praeclarum/Flybot/Hardware/Case_Flybot.stl

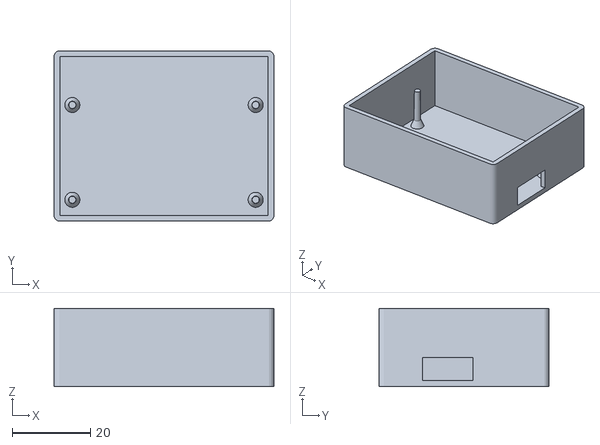
[picture p1: CAD file, 2025-08-27]
Hardware/Case_Flybot.stl
56.4 x 43.7 x 20.0
