praeclarum/Flybot/Hardware/Schematic_Flybot_2025-08-08.pdf

# USBESP⁻WROOM⁻³² WIFI

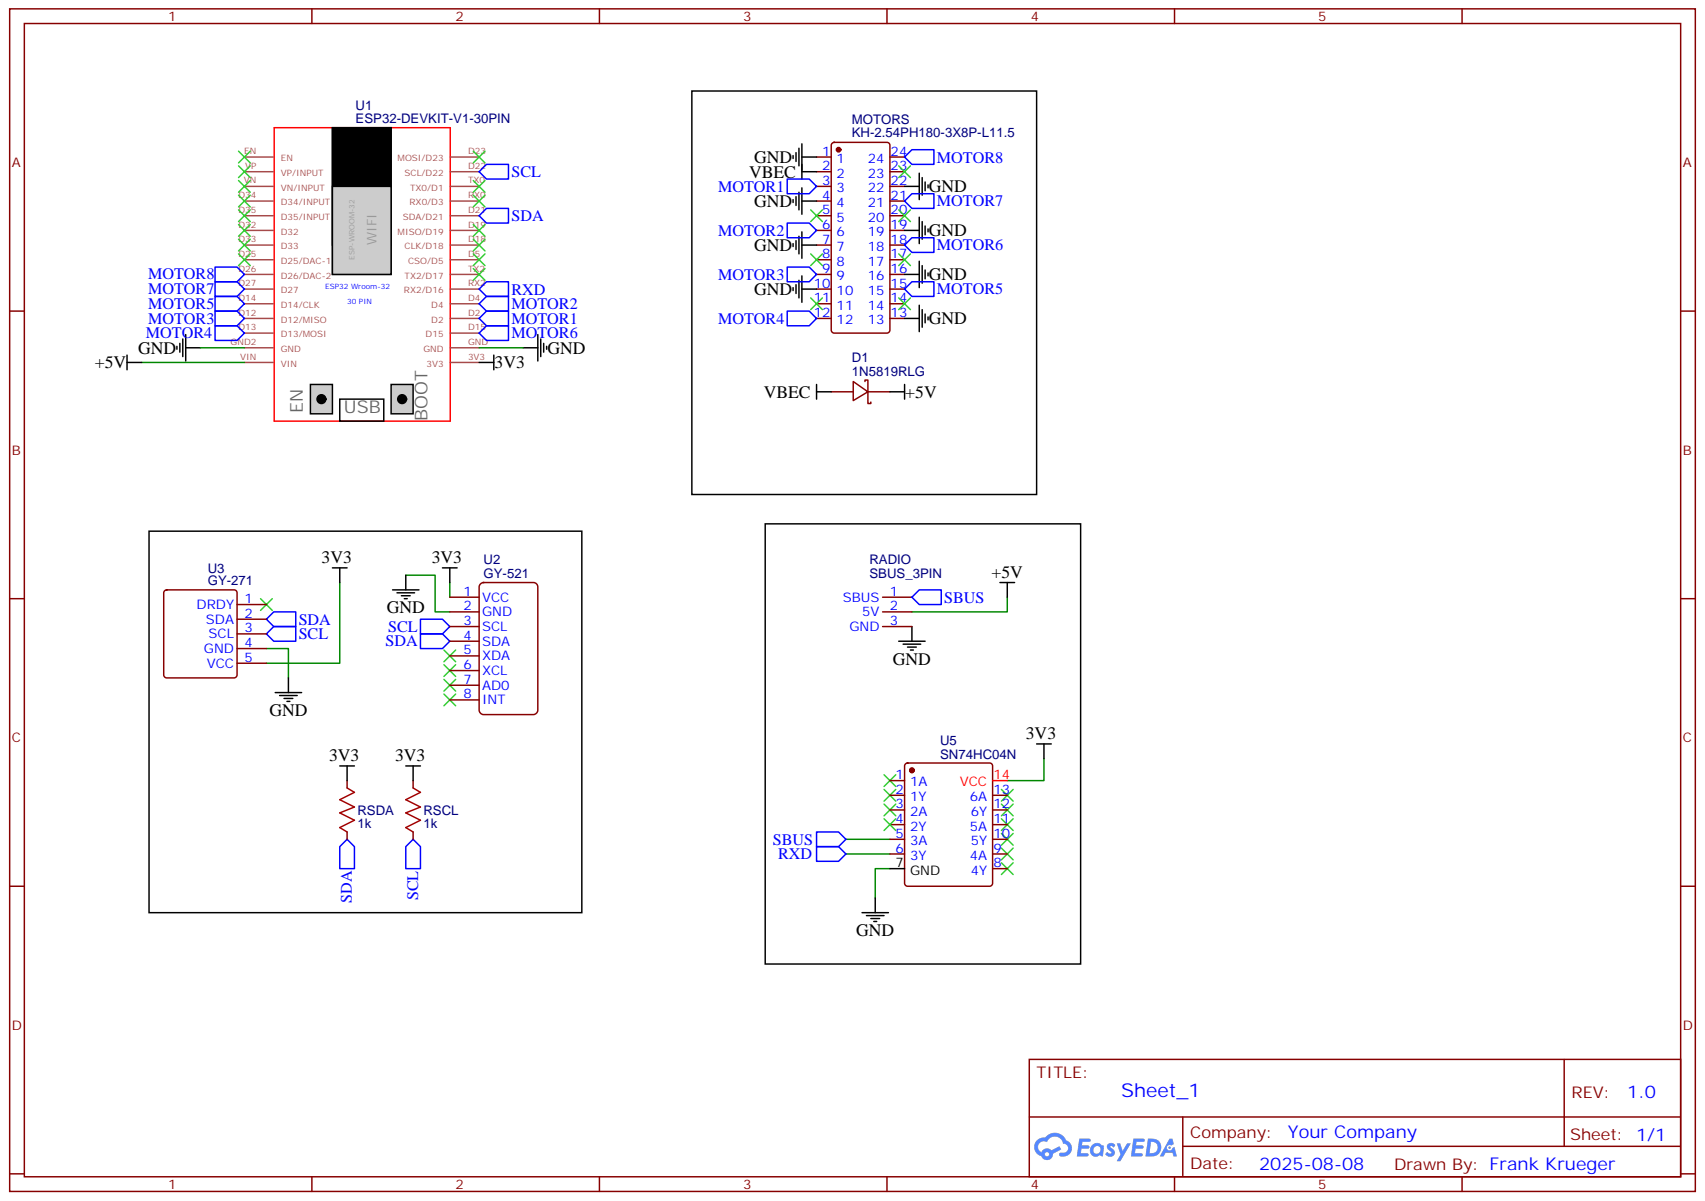
[picture p2: page 1]

Drawn By: Frank Krueger
