praeclarum/Flybot/WebServer.cpp

#define CONFIG_ASYNC_TCP_RUNNING_CORE 1
#include <ESPAsyncWebServer.h>

#include <algorithm>

#include "ConfigValue.h"

#include "State.h"

using namespace std;

void mpuBeginCalibration();

static AsyncWebServer server(80);
static AsyncWebSocketMessageHandler wsHandler;
static AsyncWebSocket ws("/ws", wsHandler.eventHandler());

static const char *cssContent PROGMEM = R"(
body {
    min-height: 100vh;
    margin: 0;
    padding: 0;
    font-family: 'Segoe UI', Arial, sans-serif;
    background: linear-gradient(180deg, #87ceeb 0%, #b3e0ff 50%, #f0f8ff 100%);
}
h1 {
    color: #1565c0;
    text-shadow: 0 2px 8px #b3e0ff;
}
input, button {
    font-size: 1.1em;
    padding: 0.4em 0.8em;
    border-radius: 6px;
    border: 1px solid #90caf9;
    margin: 0.5em 0;
}
button {
    background: #90caf9;
    color: #1565c0;
    cursor: pointer;
    box-shadow: 0 2px 6px #b3e0ff;
    border: none;
}
)";
static const size_t cssContentLength = strlen_P(cssContent);

static const char *jsContent PROGMEM = R"(

let state = {
    rollDegrees: 0.0,
    pitchDegrees: 0.0,
    yawDegrees: 0.0,
    throttlePercent: 0.0,
    armed: false,
};

const rad2deg = 180 / Math.PI;

//
// COMMUNICATIONS
//
let ws = new WebSocket('ws://flightcontroller.local/ws');
let wsConnected = false;
ws.onopen = function() {
    console.log("WebSocket connected");
    wsConnected = true;
};
ws.onmessage = function(event) {
    const data = JSON.parse(event.data);
    if (data.type === "state") {
        state.rollDegrees = data.mr * rad2deg;
        state.pitchDegrees = data.mp * rad2deg;
        state.yawDegrees = data.my * rad2deg;
        state.throttlePercent = data.rt * 100.0;
        state.armed = data.a;
        drawAll();
    }
};
ws.onclose = function() {
    wsConnected = false;
    console.log("WebSocket closed");
};
ws.onerror = function(error) {
    console.log("WebSocket error: " + error);
};
function sendCommand() {
    if (!wsConnected) return;
    const command = document.getElementById("command").value;
    ws.send("command " + command);
}
function getState() {
    if (!wsConnected) return;
    ws.send("state");
}

//
// HUD
//
function drawAll() {
    drawHUD();
}
function drawHUD() {
    const $hud = document.getElementById("hud");
    if (!$hud) return;
    const ctx = $hud.getContext("2d");
    const width = $hud.width;
    const height = $hud.height;
    ctx.clearRect(0, 0, width, height);
    ctx.fillStyle = "#ffffff";
    ctx.fillRect(0, 0, width, height);
    ctx.fillStyle = "#000000";
    ctx.font = "16px Arial";
    ctx.fillText("Roll: " + state.rollDegrees.toFixed(1) + "°", 10, 20);
    ctx.fillText("Pitch: " + state.pitchDegrees.toFixed(1) + "°", 10, 40);
    ctx.fillText("Yaw: " + state.yawDegrees.toFixed(1) + "°", 10, 60);
    ctx.fillText("Throttle: " + state.throttlePercent.toFixed(1) + "%", 10, 80);
    ctx.fillText("Armed: " + (state.armed ? "Yes" : "No"), 10, 100);
}

function startUI() {
    // Initial draw
    drawAll();
    // Update state at 2Hz
    setInterval(() => {
        getState();
    }, 1000/2);
}
startUI();
)";
static const size_t jsContentLength = strlen_P(jsContent);

static const char *htmlContent PROGMEM = R"(<!DOCTYPE html>
<html>
<head>
    <meta charset="UTF-8">
    <title>Flybot</title>
    <link rel="stylesheet" type="text/css" href="style.css" />
</head>
<body>
    <h1>Flybot</h1>
    <div>
        <canvas id="hud"></canvas>
    </div>
    <!--<div>
    <input type="text" id="command" placeholder="Send a command">
    <button onclick='sendCommand()'>Send</button>
    </div>-->
    <script type="text/javascript" src="http://192.168.112.2/flybot.js"></script>
    <script type="text/javascript">
        flybotStart("flybot.local");
    </script>
</body>
</html>
)";
static const size_t htmlContentLength = strlen_P(htmlContent);

static const char *configHtmlContent PROGMEM = R"(<!DOCTYPE html>
<html>
<head>
    <meta charset="UTF-8">
    <title>Config - Flybot</title>
    <link rel="stylesheet" type="text/css" href="style.css" />
</head>
<body>
    <h1>Flybot</h1>
    <div>
        <h2>Configuration</h2>
        <div id="config"></div>
        <pre id="raw_config"></pre>
    </div>
    <script type="text/javascript" src="http://192.168.112.2/flybot.js"></script>
    <script type="text/javascript">
        flybotConfigStart();
    </script>
</body>
</html>
)";
static const size_t configHtmlContentLength = strlen_P(configHtmlContent);

void webServerBegin() {
    // requestLogger.setEnabled(true);
    // requestLogger.setOutput(Serial);
    // server.addMiddleware(&requestLogger);
    
    server.on("/", HTTP_GET, [](AsyncWebServerRequest *request) {
        request->send(200, "text/html", (const uint8_t *)htmlContent, htmlContentLength);
    });
    server.on("/style.css", HTTP_GET, [](AsyncWebServerRequest *request) {
        request->send(200, "text/css", (const uint8_t *)cssContent, cssContentLength);
    });
    server.on("/script.js", HTTP_GET, [](AsyncWebServerRequest *request) {
        request->send(200, "application/javascript", (const uint8_t *)jsContent, jsContentLength);
    });
    server.on("/config", HTTP_GET, [](AsyncWebServerRequest *request) {
        request->send(200, "text/html", (const uint8_t *)configHtmlContent, configHtmlContentLength);
    });
    server.on("/config.json", HTTP_GET, [](AsyncWebServerRequest *request) {
        auto stream = request->beginResponseStream("application/json", 1200);
        stream->print("{");
        const char *head = "";
        configValuesIterate([&](const String &key, const Value &value) {
            stream->print(head);
            stream->print("\"");
            stream->print(key);
            stream->print("\":");
            stream->print(value.toString());
            head = ",";
        });
        stream->print("}");
        request->send(stream);
    });
    server.on("/config_defaults.json", HTTP_GET, [](AsyncWebServerRequest *request) {
        auto stream = request->beginResponseStream("application/json", 1200);
        stream->print("{");
        const char *head = "";
        configDefaultValuesIterate([&](const String &key, const Value &value) {
            stream->print(head);
            stream->print("\"");
            stream->print(key);
            stream->print("\":");
            stream->print(value.toString());
            head = ",";
        });
        stream->print("}");
        request->send(stream);
    });
    server.on("/config_value", HTTP_POST, [](AsyncWebServerRequest *request) {
        const auto key = request->arg("key");
        const auto valueString = request->arg("value");
        const auto success = configValueSetString(key, valueString);
        request->send(200, "application/json", "{\"success\":" + String(success ? "true" : "false") + "}");
    });
    server.on("/config_restore", HTTP_POST, [](AsyncWebServerRequest *request) {
        const auto key = request->arg("key");
        const auto success = configValueRestore(key);
        request->send(200, "application/json", "{\"success\":" + String(success ? "true" : "false") + "}");
    });
    server.on("/mpu_calibrate", HTTP_POST, [](AsyncWebServerRequest *request) {
        mpuBeginCalibration();
        request->send(200, "application/json", "{\"success\":true}");
    });

    wsHandler.onConnect([](AsyncWebSocket *server, AsyncWebSocketClient *client) {
        server->text(client->id(), "{\"type\":\"hello\"}");
    });
    wsHandler.onDisconnect([](AsyncWebSocket *server, uint32_t clientId) {
        server->text(clientId, "{\"type\":\"goodbye\"}");
    });
    wsHandler.onError([](AsyncWebSocket *server, AsyncWebSocketClient *client, uint16_t errorCode, const char *reason, size_t len) {
    });
    wsHandler.onMessage([](AsyncWebSocket *server, AsyncWebSocketClient *client, const uint8_t *data, size_t len) {
        if (strncmp((const char *)data, "state", min((size_t)5, len)) == 0) {
            const State &state = getState();
            String stateData = "{\"type\":\"state\",\"mr\":" + String(state.rollRadians, 3)
                + ",\"mp\":" + String(state.pitchRadians, 3)
                + ",\"my\":" + String(state.yawRadians, 3)
                + ",\"rr\":" + String(state.rcRollRadians, 3)
                + ",\"rp\":" + String(state.rcPitchRadians, 3)
                + ",\"ry\":" + String(state.rcYaw, 3)
                + ",\"rt\":" + String(state.rcThrottle, 3)
                + ",\"fs\":" + String(state.flightStatus)
                + ",\"hf\":" + String(state.hardwareFlags)
                + ",\"ep\":" + String(state.pitchErrorRadians, 3)
                + ",\"er\":" + String(state.rollErrorRadians, 3)
                + ",\"m1\":" + String(state.motor1Command, 3)
                + ",\"m2\":" + String(state.motor2Command, 3)
                + ",\"m3\":" + String(state.motor3Command, 3)
                + ",\"m4\":" + String(state.motor4Command, 3)
                + ",\"m5\":" + String(state.motor5Command, 3)
                + ",\"m6\":" + String(state.motor6Command, 3)
                + "}";
            server->text(client->id(), stateData);
            return;
        }
        server->text(client->id(), "{\"type\":\"echo\",\"d\":\"" + String((const char *)data, len) + "\"}");
    });
    wsHandler.onFragment([](AsyncWebSocket *server, AsyncWebSocketClient *client, const AwsFrameInfo *frameInfo, const uint8_t *data, size_t len) {
    });

    server.addHandler(&ws);
    server.begin();
}
