praeclarum/Flybot/(commit log)

2025-08-08 Add PID
2025-08-09 Add board v1.0
2025-08-09 Add schematic
2025-08-09 Scale gyro to rad/sec
2025-08-09 Add MPU calibration
2025-08-09 Use quaternions to find axis errors
    [ControlLoop.cpp, Geometry.h]
2025-08-11 Detect and recover from MPU errors
    [MPU.cpp, MPU.h, MPU6050.cpp, MPU6050.h, flybot.js]
2025-08-11 Handle SBUS packet errors
    [RadioController.cpp]
2025-08-11 Decrease default max pitch and roll
2025-08-11 Remove update button
2025-08-22 Mix motors
2025-08-22 Fix motor reversing
2025-08-26 Add ESC calibration procedure
2025-08-26 Always send motor commands
2025-08-26 Remove reversed from motor setup
    [Motors.cpp, Motors.h]
2025-08-27 Add case
    [Case_Flybot.stl]
2025-08-28 Only run MPU calibration from web
2025-09-03 Add landing gear
